mhanyasoos/group-15-project/FINAL2 GROUP PROJECT POSTER.pdf

## Main Conclusions

- The variation of student temperature estimates highlights the | discrepancy between
perceived temperature and measured values, | particularly in the Lecture Theatre.
- Despite higher CO | ₂ levels in the Student Centre and lower average temperatures in the
lecture theatre, subjective responses indicate | greater discomfort in the lecture theatre
suggesting that | discomfort | cannot be attributed to a single environmental variable | .
- Architectural features such as | windows and ventilation | created measurable differences
between L2 and L4 of the Student Centre.
- The laboratory emerged as | the most thermally stable environment | but this requires
further validation at periods with higher occupancy.

## Evaluation

Our project successfully produced 2 systems that can measure environmental data across multiple locations . However, the subjective data used to correlate this to thermal sensation was severely limited by a small participant sample and one dataset per location .
Future studies should incorporate | a greater number of locations to validate the data on
temperature | perception . Also, integrating | the wireless system into a wristband structure
could allow the validation of skin temperature data against human perception .

# Development and testing of a data collection system for thermoregulation and thermal comfort studies

## Amna Al - Meraikhi 1

## , Anchena Senthilkumaran 1 , Molly Hanya 2, Weicheng Yu 2, Anniqa Sofia Ahmad Hadri 2

Supervised by Pilar Garcia Souto | 2
System Setup System Setup System Setup Calibration Sensor Data Participant Data Collection System Setup System Setup Collection Participant Questions 1. On a scale from - 3 to +3, how would you describe the environment? 2. Are you comfortable? 3. What temperature do you think it is? | +3 | Hot
| +2 | Warm
| +1 | Slightly Warm
| 0 Neutral
| - 1 | Slightly Cool
| - 2 | Cool
| - 3 | Cold

REFERENCES

Figure 3: Experimental method pipeline . The questions use the PMV model [2] to compare an individual’s subjective sensation to the environment .

[1] M. Marigo et al., “Thermal comfort and productivity in a workplace : An alternative approach evaluating productivity management inside a test room using textual analysis,” Building and Environment , vol . 245 , p. 110836 , Nov . 2023 , doi : https (https://doi.org/10.1016/j.buildenv.2023.110836) : (https://doi.org/10.1016/j.buildenv.2023.110836)//doi (https://doi.org/10.1016/j.buildenv.2023.110836) .org/ (https://doi.org/10.1016/j.buildenv.2023.110836) 10. (https://doi.org/10.1016/j.buildenv.2023.110836)1016 (https://doi.org/10.1016/j.buildenv.2023.110836)/j. (https://doi.org/10.1016/j.buildenv.2023.110836)buildenv (https://doi.org/10.1016/j.buildenv.2023.110836) .2023 (https://doi.org/10.1016/j.buildenv.2023.110836) .110836 (https://doi.org/10.1016/j.buildenv.2023.110836) .
[2] ASHRAE . Thermal sensation scale, 2021 .
Key : | Temperature | Humidity | CO ₂ Concentration
Figure 4: Summary of the average temperature and humidity measurements | recorded by the wireless
system in conjunction with the average CO ₂ measurements recorded by the wired system .
- Student Centre : 71.4% of participants reported feeling ‘slightly warm’ (+1 on the PMV scale) .
- Lecture | Theatre : Responses | were
highly | varied, | with | 47 .6% | feeling
‘neutral’ (0 ), 28 .6% ‘slightly warm’ (+1), and 23 .8% ‘slightly cool’ (- 1).
- Discomfort | Levels : | 14.3% | of
participants | reported | feeling
uncomfortable | in the Student Centre,
compared | to 23 .8% in the Lecture
Theatre .

## Experimental Results

## Environmental Data of UCL Locations

Student Centre L2
23.27 (0.38) °C

44.8% 802.9 (65.8) ppm

Student Centre L4
22.99 (0.21) °C

43.15% 771.5 (12.3) ppm

MPBE Laboratory
22.58 (0.41) °C

44.0 % 446.1 (57.3) ppm

XLG1 Lecture Theatre
20.57 (0.87) °C

42.6% 585.7 (105.1) ppm

### 1. Peak CO ₂ in High -

Traffic Zones

## Discussion

### 2. Temperature

Variance & Congestion

### 3. Overall

Environmental Stability

- The highest CO ₂ levels
were recorded in Student
Centre | L 2, peaking | at
1047 ppm .
- This is due to factors
such as high occupancy,
continuous foot traffic
and limited ventilation .
- The highest temperature
of 23 .27 °C was recorded
in the Student Centre L 2, due to congestion during
midday .
- Lecture Theatre showed
the greatest temperature
variation due to early
morning data collection .
- Humidity levels were lowest
in spacious | locations | and
higher in areas with poor
ventilation .
- Overall, the measurements
suggest the Laboratory | to
be the most | thermally -
stable environment, but this needs further validation .

## Subjective Survey Data

Figure | 5: Frequency | distribution | of subjective | ambient
temperature | estimates | reported by occupants | in the XLG 1
Lecture | Theatre . Column | colours | visually | represent | the
temperature spectrum, from cooler (blue) to warmer (red) .

Temperature Value / °C

Frequency

Wired
Reference System

Wireless
Wearable Node

## Research Objectives

Arduino Giga R1 | XIAO ESP32C3
Designing and | Characterising | a Dual - System Approach

## to Environmental Monitoring

to capture high - accuracy baseline data for ambient
temperature, humidity, and CO ₂ concentration

to monitor real - time skin and surface temperatures,
providing a mobile ‘personal’ data point

Hardware

Objective

## The Hypothesis

- By correlating | physical | sensor | data | (using | high - precision
components | such as SHT 45 and SDC 41) with subjective user

## surveys across diverse UCL environments, we can define the

environmental thresholds that dictate human comfort .

## The Problem

## - Thermal comfort is a complex subjective state influenced by

ambient conditions, CO ₂ levels, and physiological factors .
- Traditional | HVAC | (Heating, | Ventilation | and | Air
Conditioning) systems rely on static wall - mounted thermostats,

## which often fail to account for the ‘Discursive Gap’ [1] between

sensor readings and actual human perception .

Sensor 1

Wireless
System

CSV File

Sensor data
transmitted via
Wi- Fi .

Data stored in
Cloud and exported
as CSV .

Dashboard created
to display current
measurements.

Figure 1: Conceptual design of System 2.0 . It consists of wired and wireless components transmitting data to a shared
receiver . All sensors are connected | to the microcontrollers | via Inter- Integrated Circuit (I2C) communication | for its
simplicity .

Figure 2: Method of data transfer by wired and wireless systems . The wireless system uses Arduino Cloud for data storage, and data collected throughout the day is exported as a CSV file for each sensor and variable . The wired system uses Python as a medium and outputs the data as an array which is then extracted as a JSON file for further analysis .

## Experimental Design

Sensor 3

Sensor 2

Microcontroller | Receiver

Rechargeable
Battery
Microcontroller | Sensor 4

Rechargeable
Battery
Microcontroller | Sensor 5

Rechargeable
Battery
Microcontroller | Sensor 6
Wired System | Wireless System

Arduino
Cloud

Wired
System

JSON File

Sensor data
transmitted via
cable (Serial) .

Data exported and
saved as JSON .

Data continuously
monitored and
plotted on a live
graph .

Python

## Methodology

## 1Department of Medical Physics and Biomedical Engineering, UCL

## 2 Department of Physics and Astronomy, UCL
