mhanyasoos/group-15-project/(commit log)

2026-03-09 Code for MCP9808, SHT45, and SCD41 sensors
    This code initialises and reads data from three sensors: MCP9808, SHT45, and SCD41. It prints the sensor data in CSV format.
2026-03-09 README for Wireless Thermal Comfort Sensing System
    This README provides an overview of the wireless thermal comfort sensing system, detailing its architecture, repository structure, methodology, safety compliance, and affiliation.
2026-03-11 Arduino code for MCP9808, SHT45, and SCD41 sensors - C++
2026-03-22 Code for Arduino IoT MCP9808
    Ensure that mCPTemp is pre-defined as a float in IoT Cloud.
2026-03-22 MAX30205 Arduino Cloud Code
